crasbe/Protein/Pics/IMG_20130914_145044.jpg

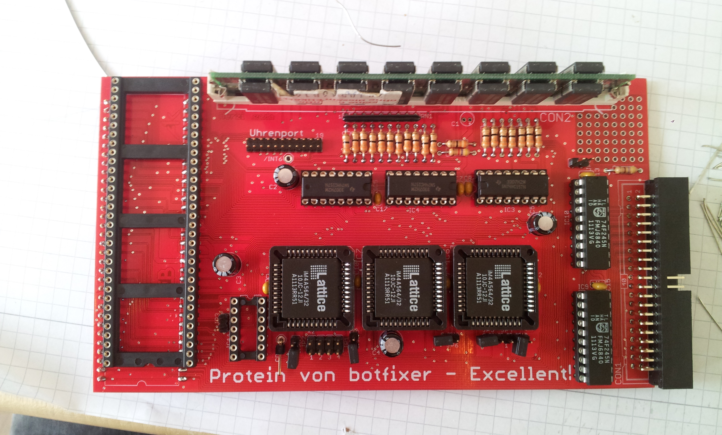
Pics/IMG_20130914_145044.jpg
