crasbe/Protein/Software/original/untouched_sources/DRAM/Projekt/a600_8mb_addon/a600_8mb_addon/4mb/README.txt

4mb version, PCMCIA friendly.

Memory is at $200000-$5fffff.

SOLDER ORDER: for pure 4mb board, solder only two RIGHT memory chips.
On the fully populated board, redundant chips will be inactive so everything OK.
