crasbe/Protein/Hardware/ISP-Rev.-1.0/pcb.png

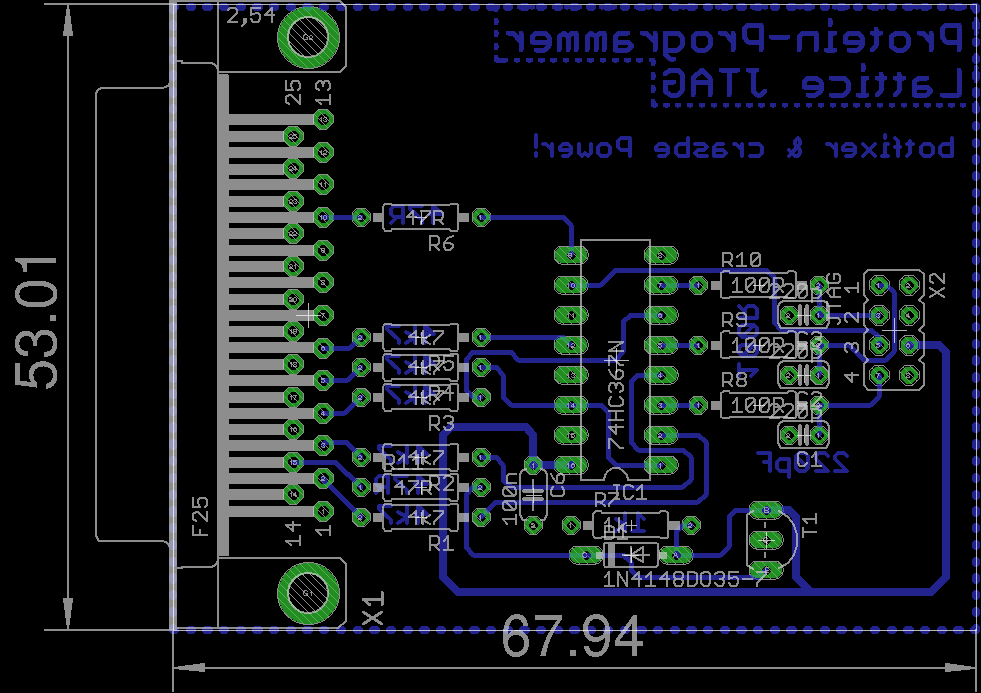
Hardware/ISP-Rev.-1.0/pcb.png
