crasbe/Protein/Hardware/ISP-Rev.-1.2/pcb.png

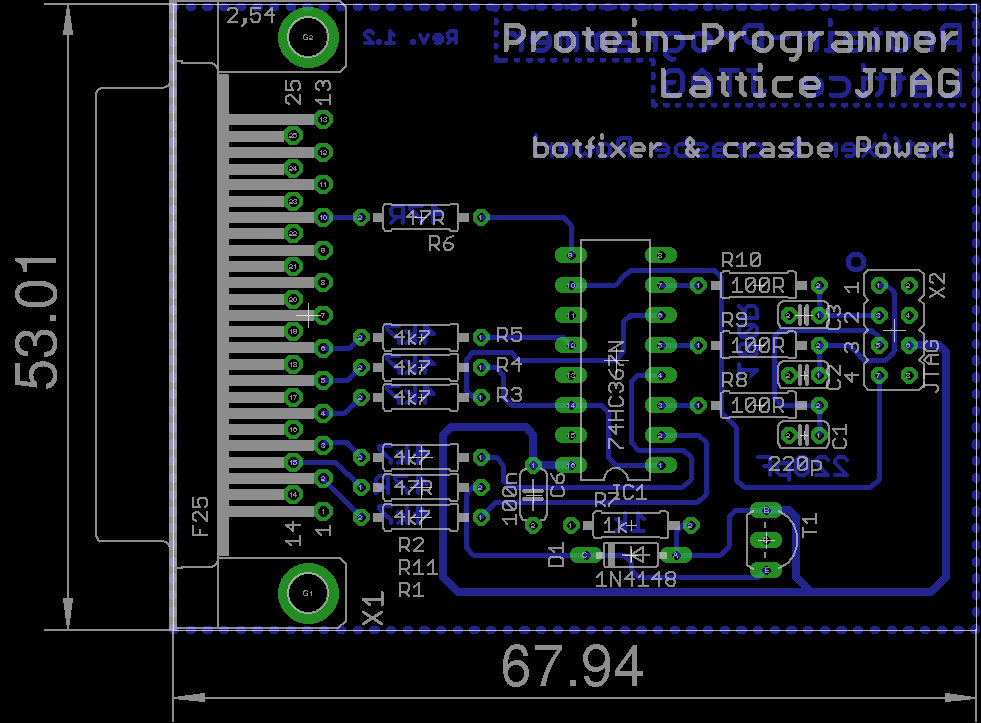
Hardware/ISP-Rev.-1.2/pcb.png
