crasbe/Protein/Hardware/Rev.-1.0/pcb.png

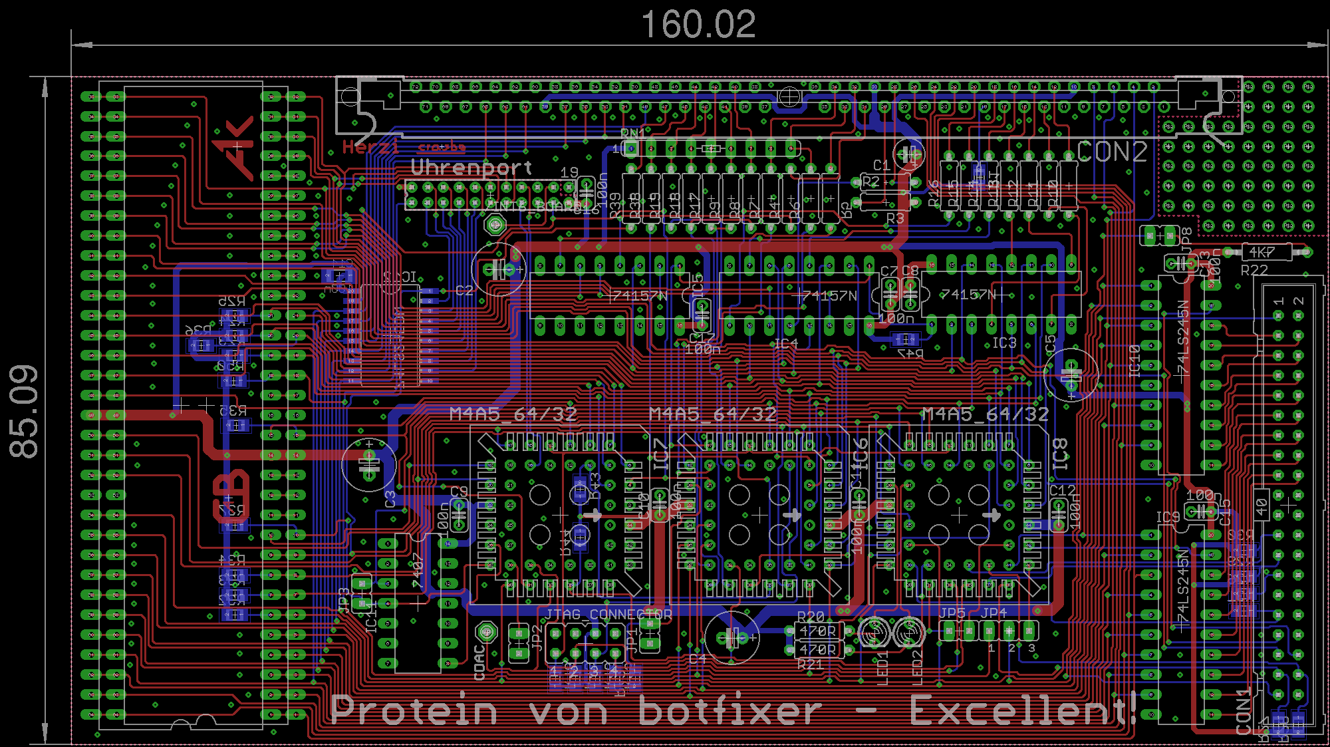
Hardware/Rev.-1.0/pcb.png
