crasbe/Protein/Hardware/Rev.-1.1/pcb.png

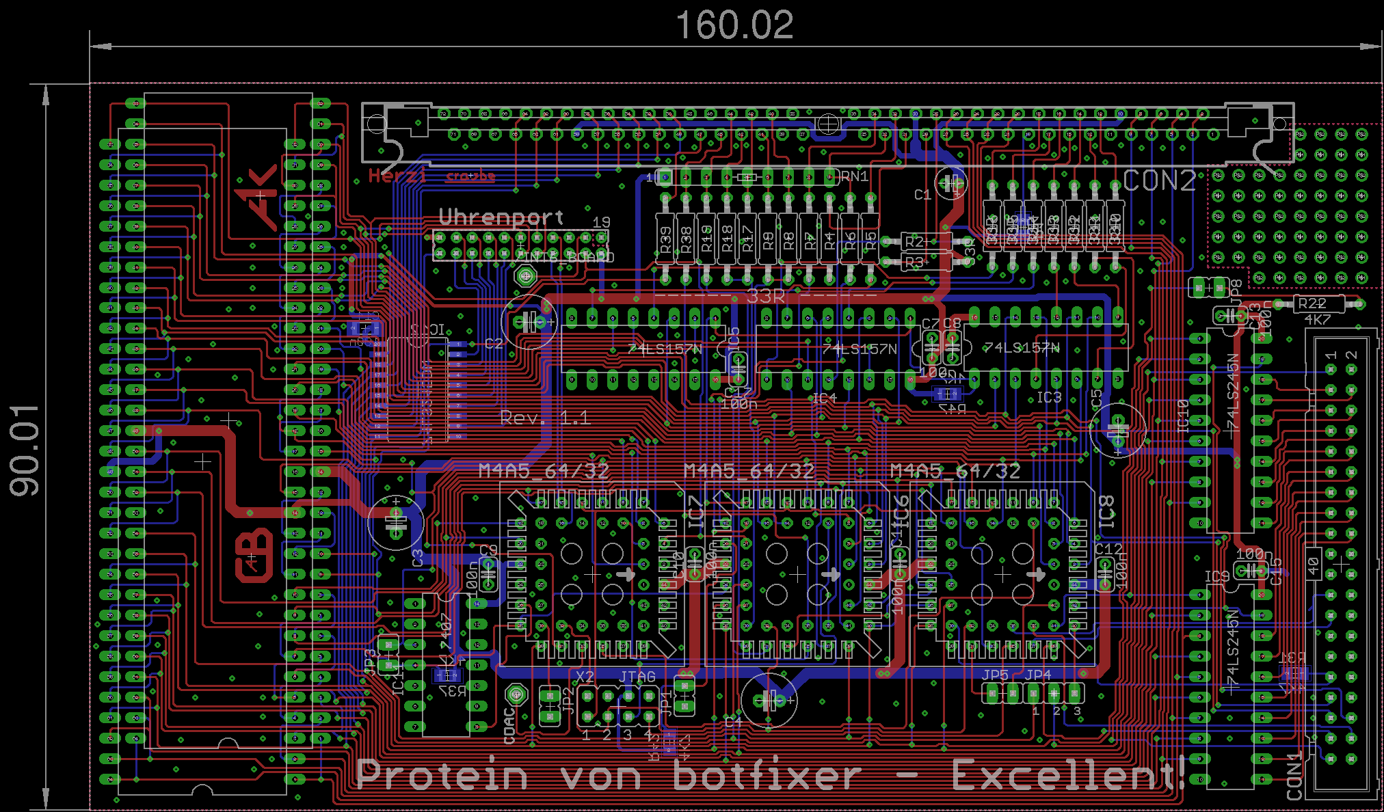
Hardware/Rev.-1.1/pcb.png
