crasbe/Protein/Hardware/Rev.-1.2/pcb.png

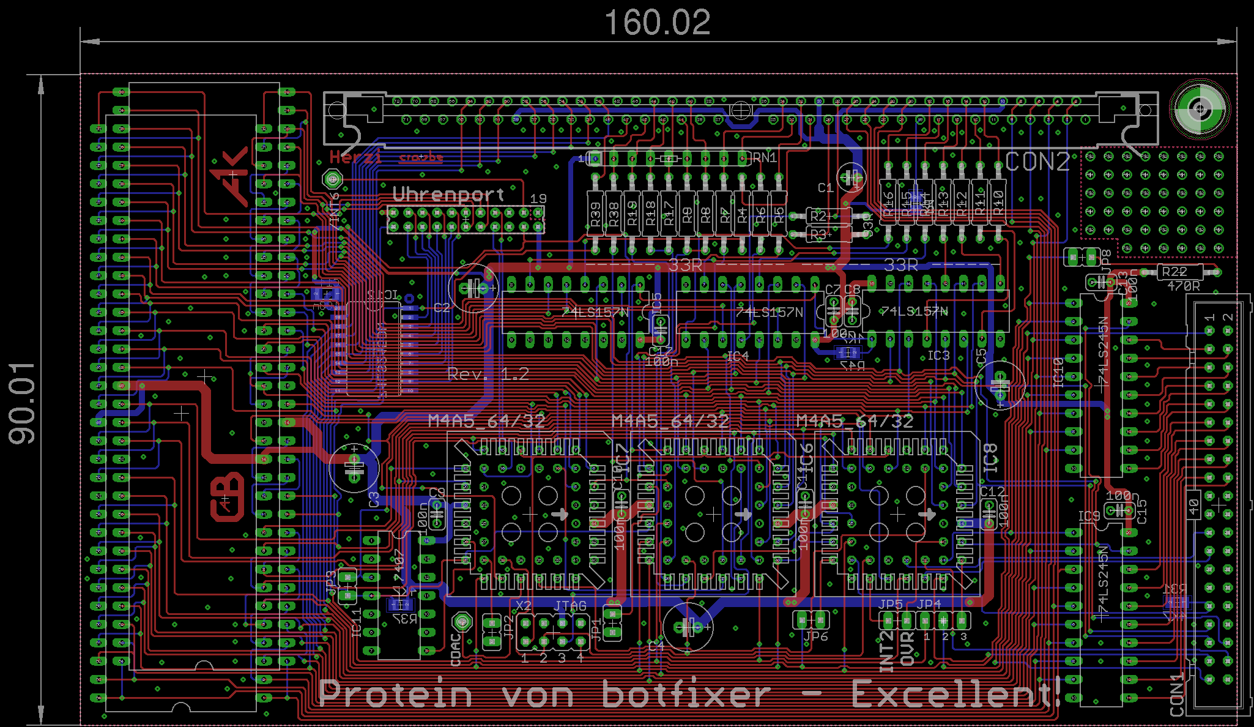
Hardware/Rev.-1.2/pcb.png
