crasbe/Protein/Pics/IMG_20130913_210121.jpg

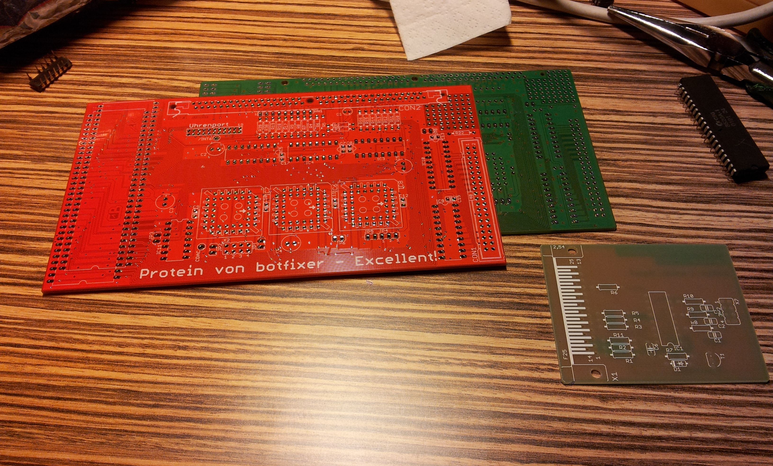
Pics/IMG_20130913_210121.jpg
