crasbe/Protein/Pics/IMG_20130913_210151.jpg

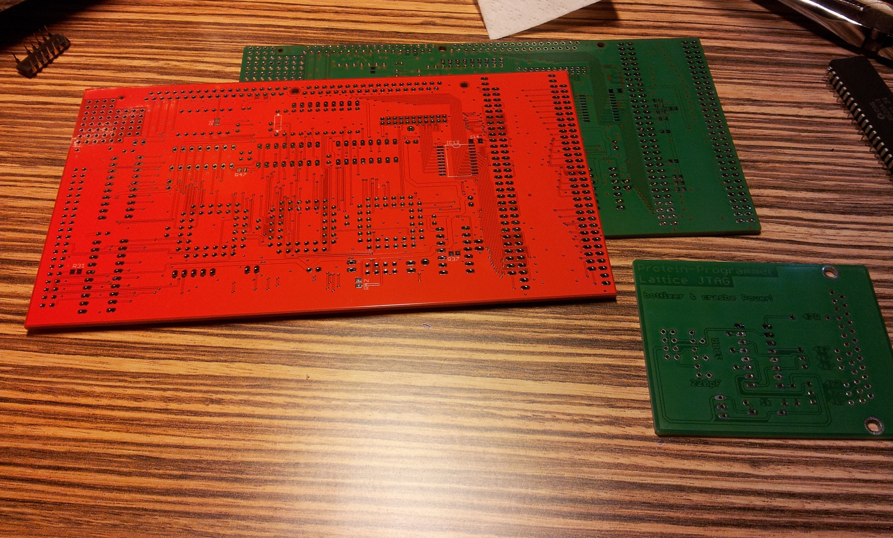
Pics/IMG_20130913_210151.jpg
