crasbe/Protein/Pics/IMG_20130914_150607.jpg

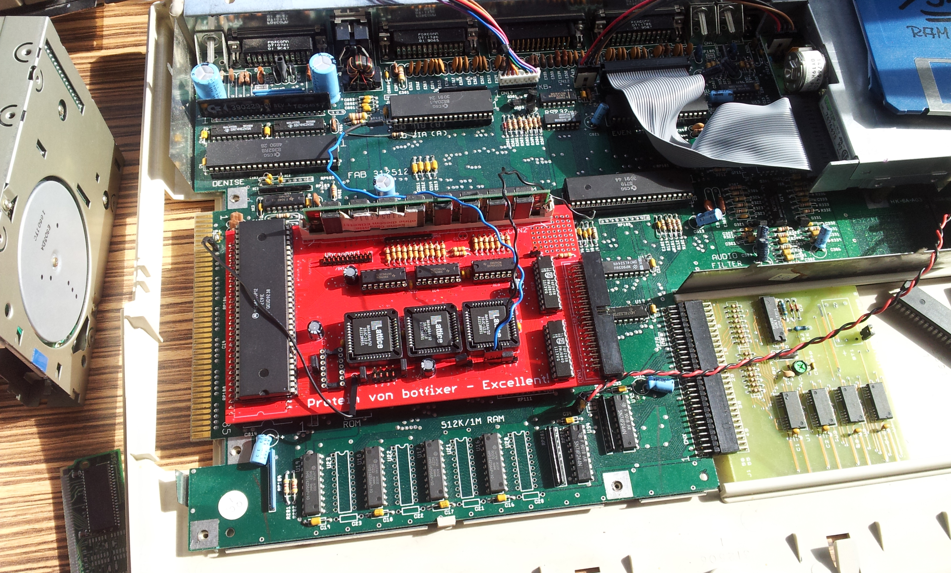
Pics/IMG_20130914_150607.jpg
