crasbe/Protein/Pics/IMG_20130914_170321.jpg

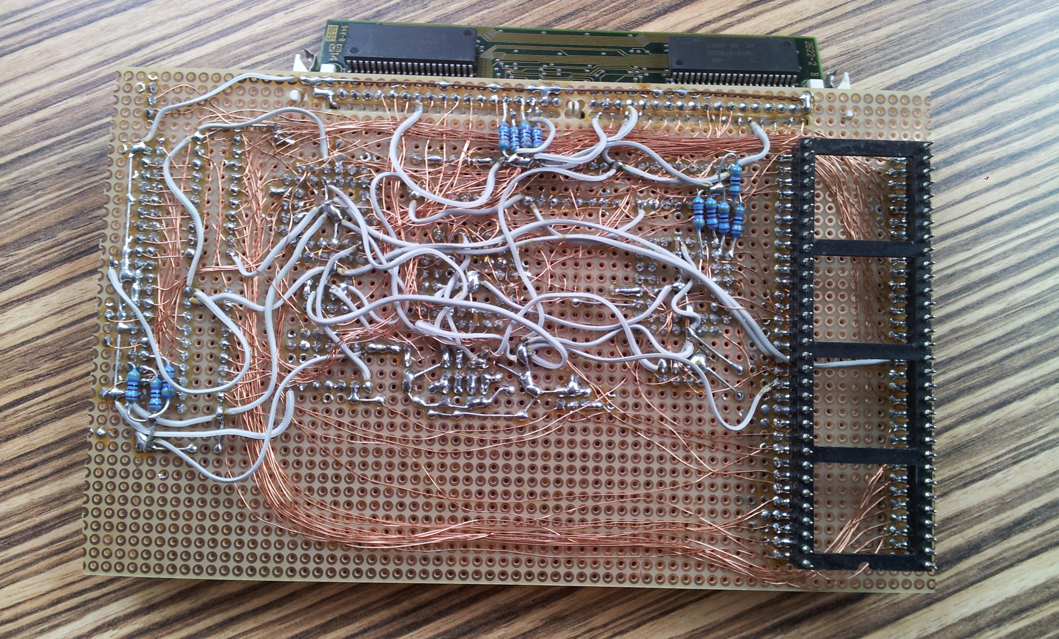
Pics/IMG_20130914_170321.jpg
