crasbe/Protein/Pics/IMG_20130914_170358.jpg

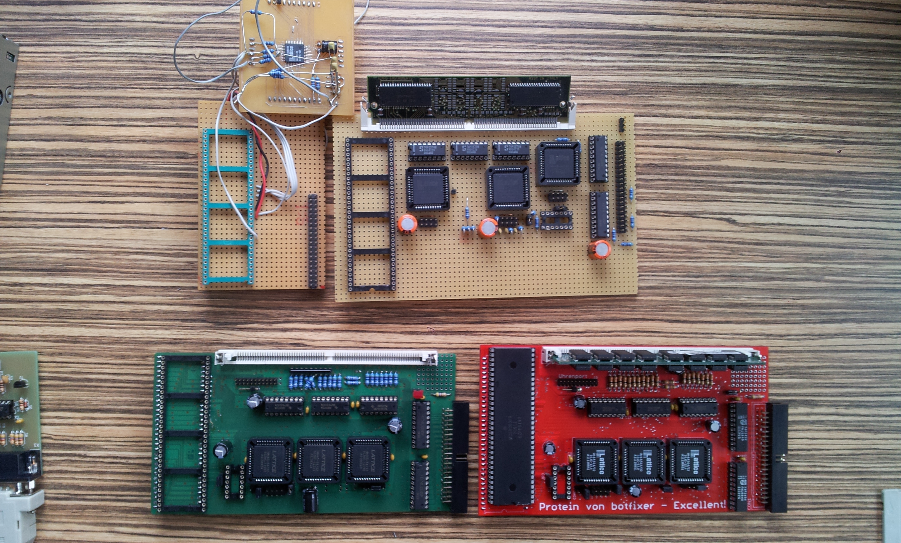
Pics/IMG_20130914_170358.jpg
