crasbe/Protein/Software/original/untouched_sources/Clockport/Clockport.png

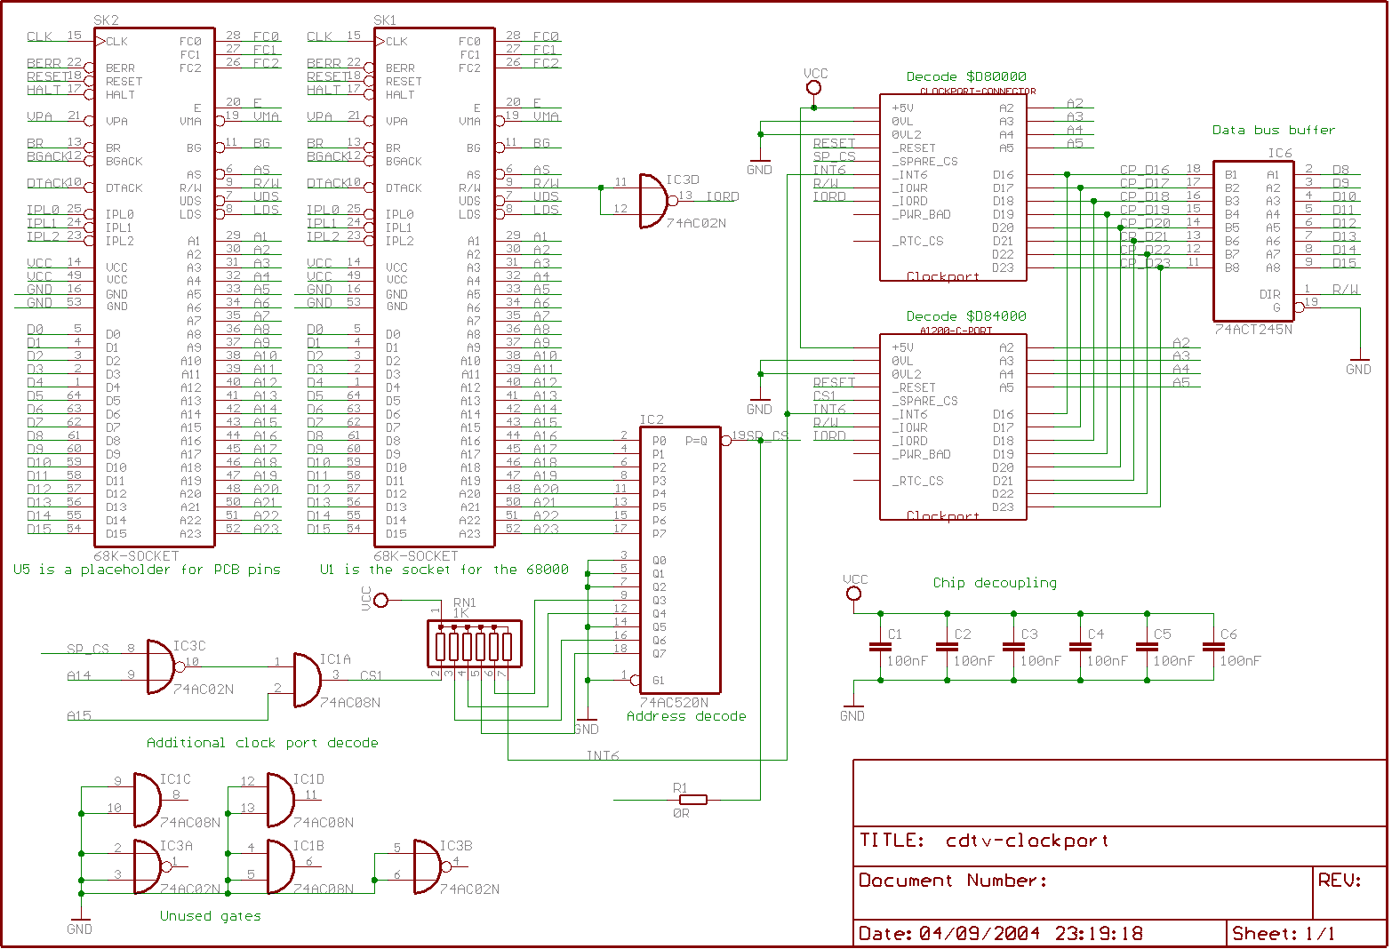
Software/original/untouched_sources/Clockport/Clockport.png
