crasbe/Protein/Software/original/untouched_sources/DRAM/Projekt/a600_8mb/a600_8mb/photos/4.jpg

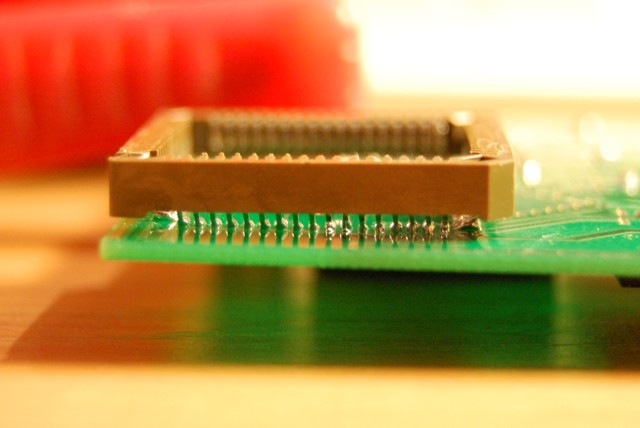
Software/original/untouched_sources/DRAM/Projekt/a600_8mb/a600_8mb/photos/4.jpg
