crasbe/Protein/Software/original/untouched_sources/IDE/IDE-harddisk projects for Amiga-Dateien/abidebot.jpg

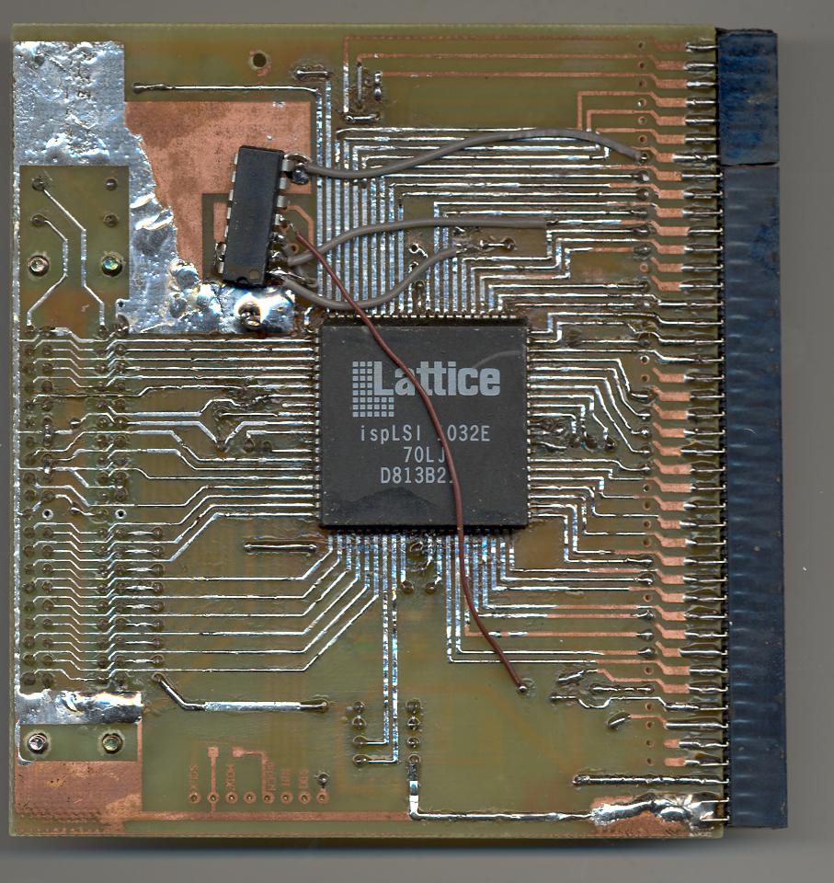
Software/original/untouched_sources/IDE/IDE-harddisk projects for Amiga-Dateien/abidebot.jpg
