crasbe/Protein/Software/original/untouched_sources/IDE/IDE-harddisk projects for Amiga-Dateien/abidetop.jpg

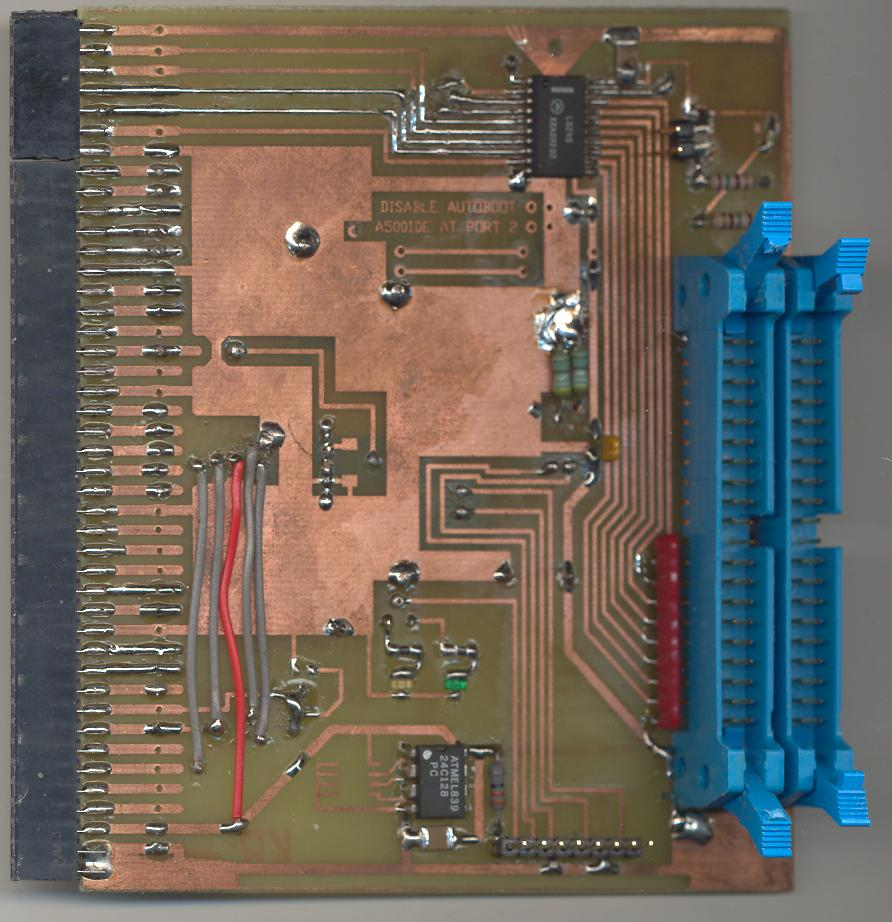
Software/original/untouched_sources/IDE/IDE-harddisk projects for Amiga-Dateien/abidetop.jpg
