crasbe/Protein/Hardware/ISP-Rev.-1.0/lattice-isp-pcb.pdf

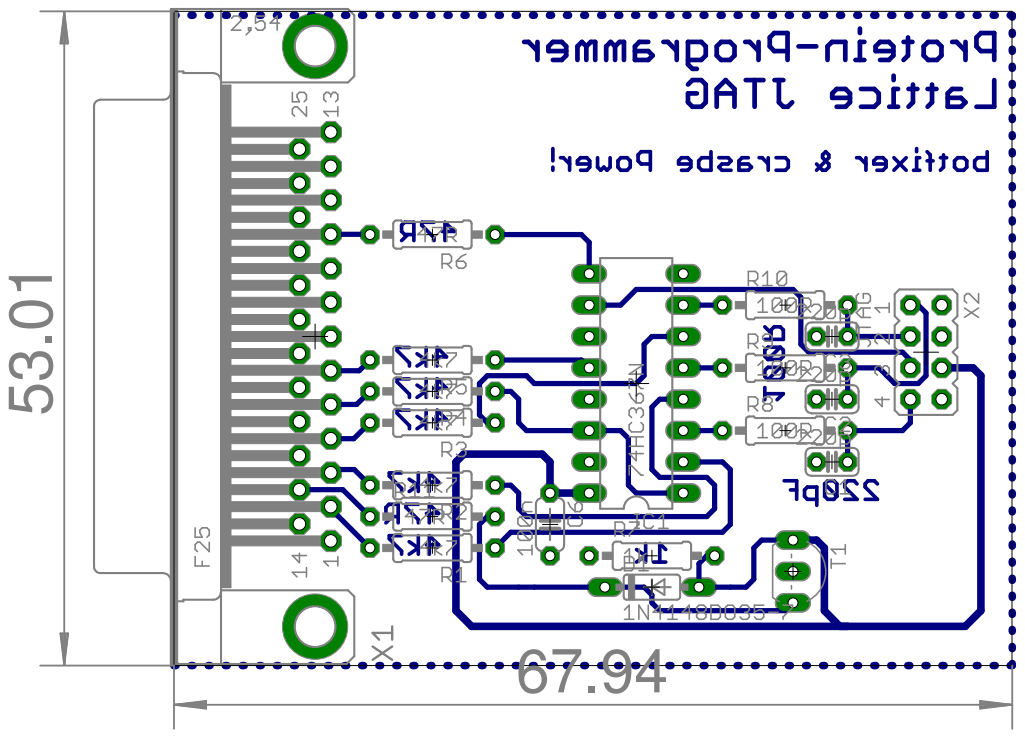
[picture p24: page 1]
