crasbe/Protein/Hardware/ISP-Rev.-1.0/lattice-isp-sch.pdf

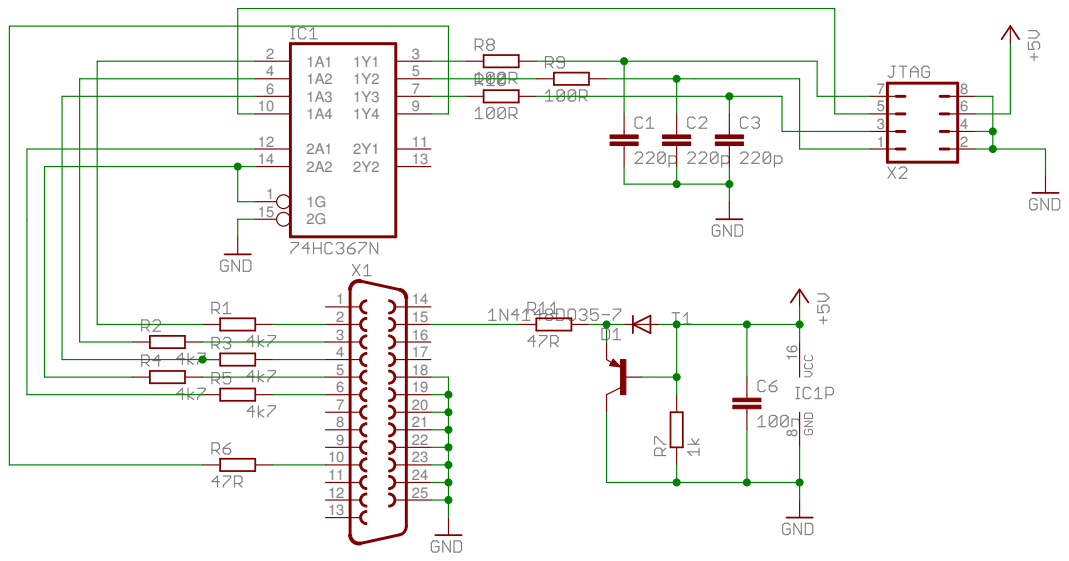
[picture p25: page 1]
