crasbe/Protein/Hardware/ISP-Rev.-1.2/lattice-isp-brd.pdf

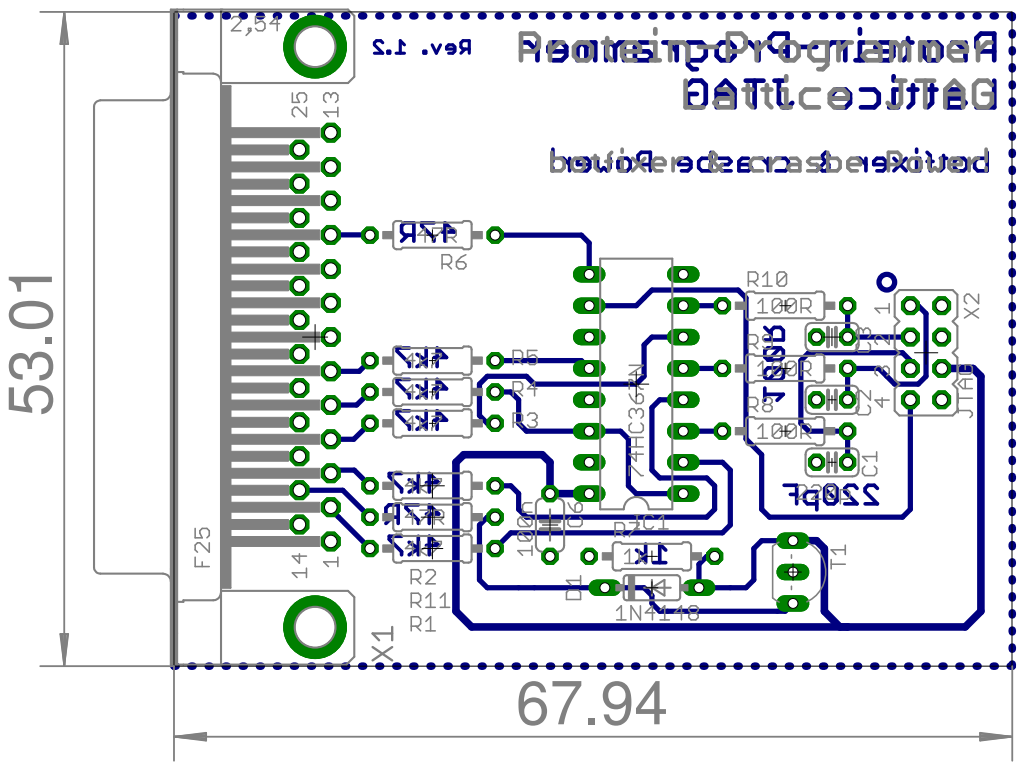
[picture p26: page 1]
