crasbe/Protein/Hardware/ISP-Rev.-1.2/lattice-isp-sch.pdf

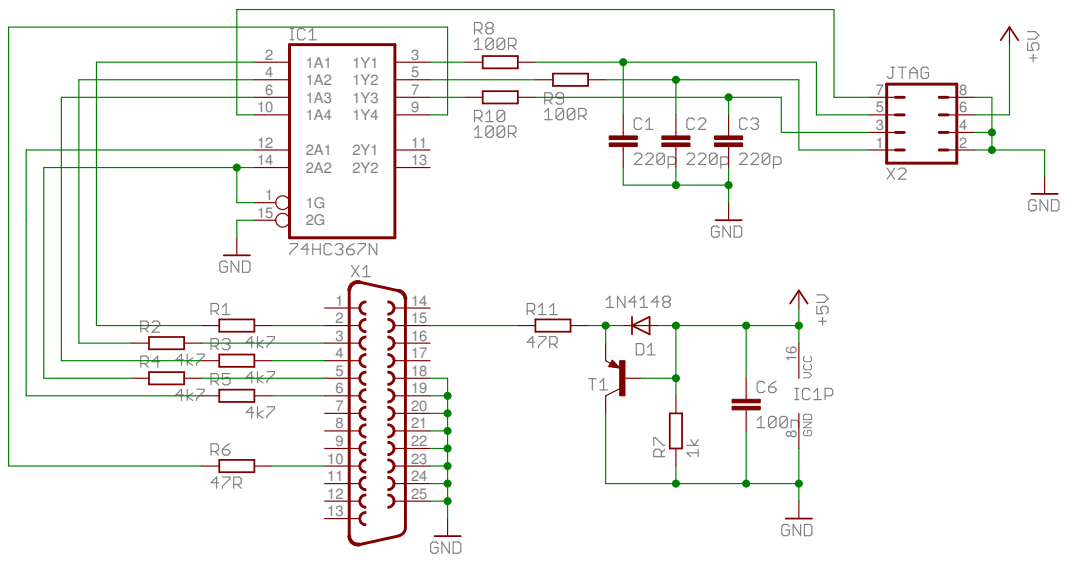
[picture p27: page 1]
