crasbe/Protein/Hardware/Rev.-1.0/Protein-brd.pdf

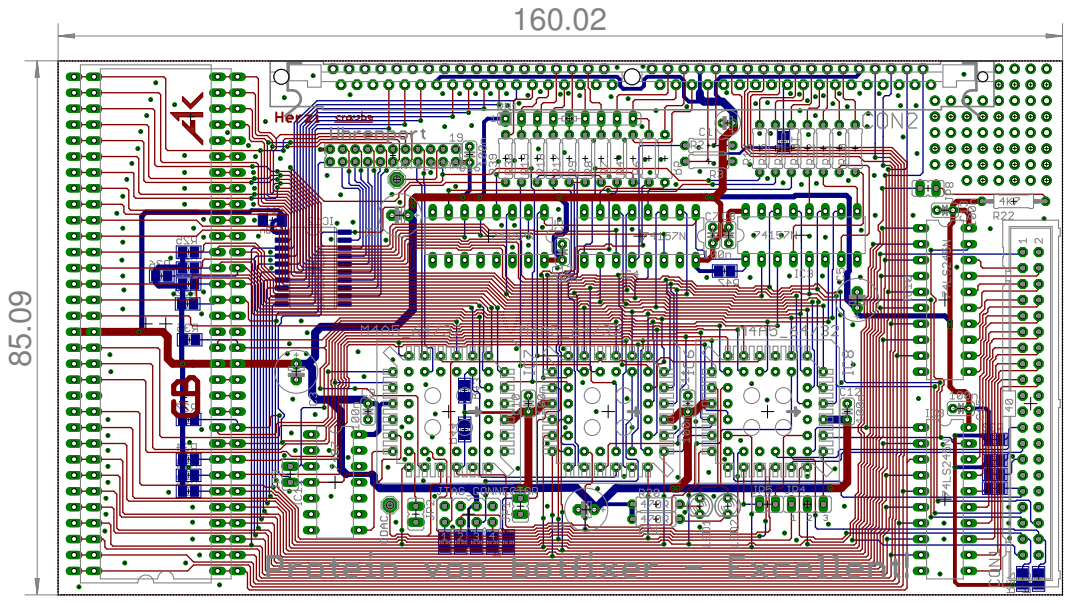
[picture p28: page 1]
