crasbe/Protein/Hardware/Rev.-1.0/Protein-sch.pdf

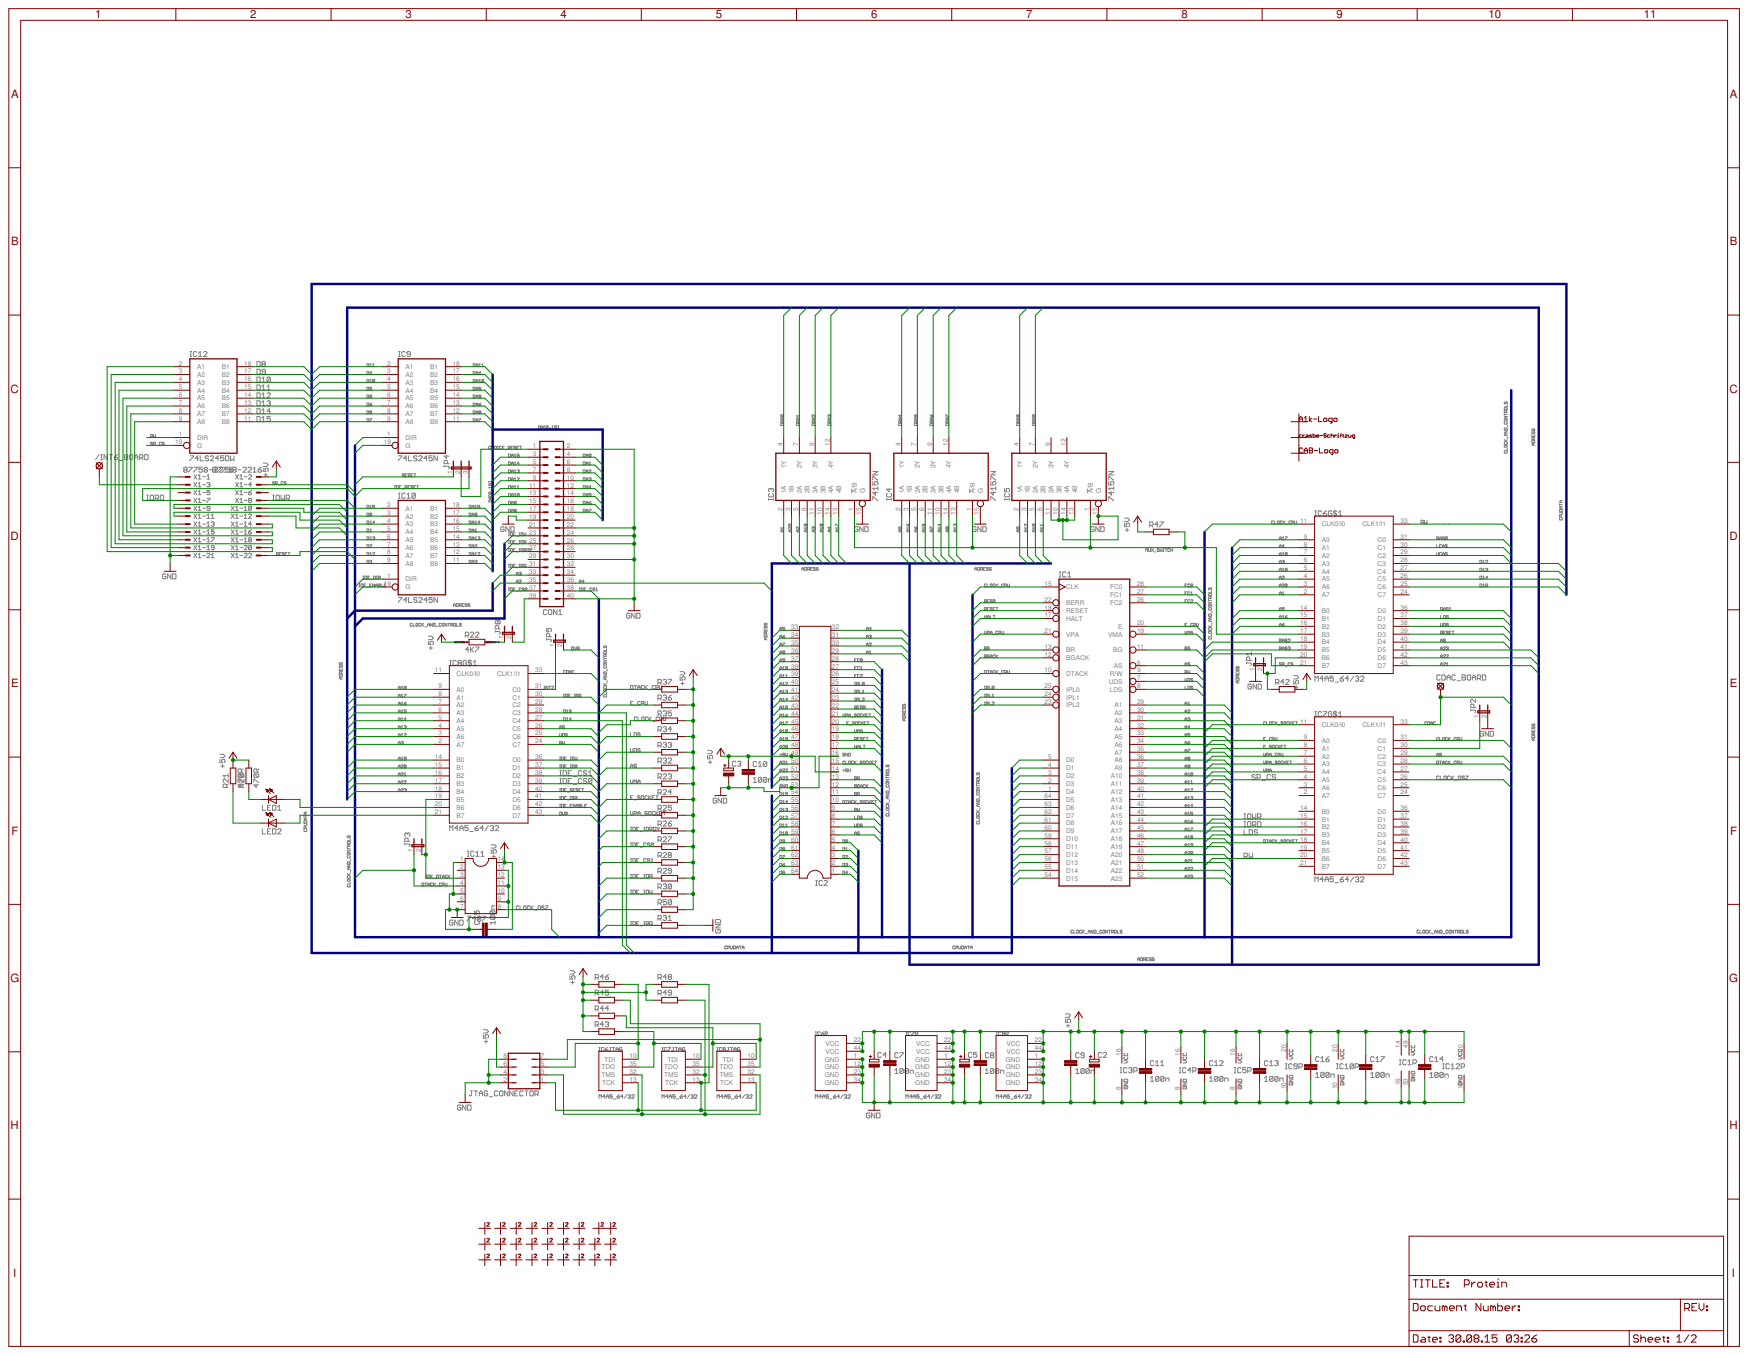
[picture p29: page 1]

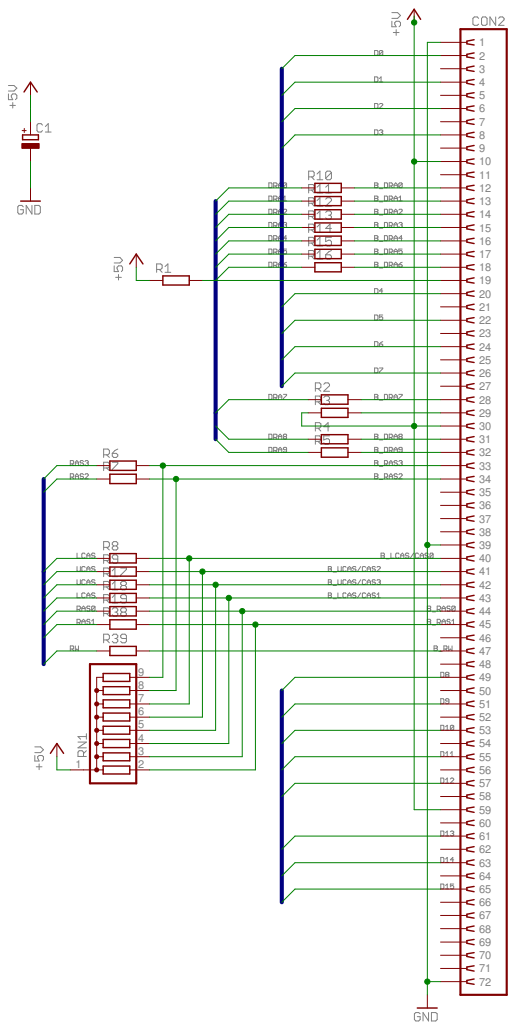
[picture p30: page 2]
