crasbe/Protein/Hardware/Rev.-1.1/Protein-brd.pdf

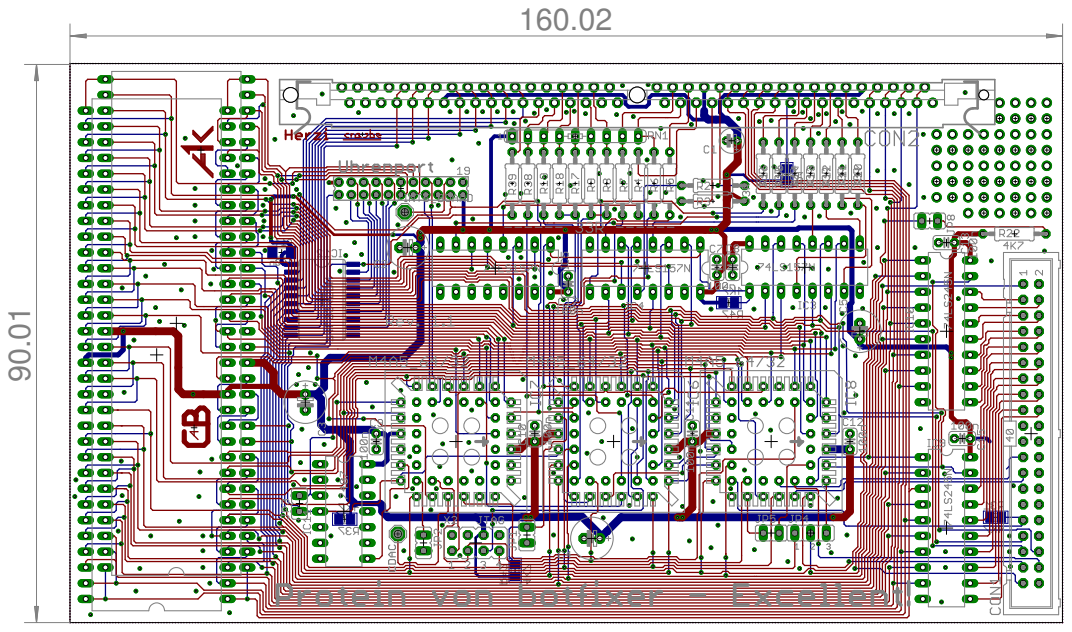
[picture p31: page 1]
