crasbe/Protein/Hardware/Rev.-1.1/Protein-sch.pdf

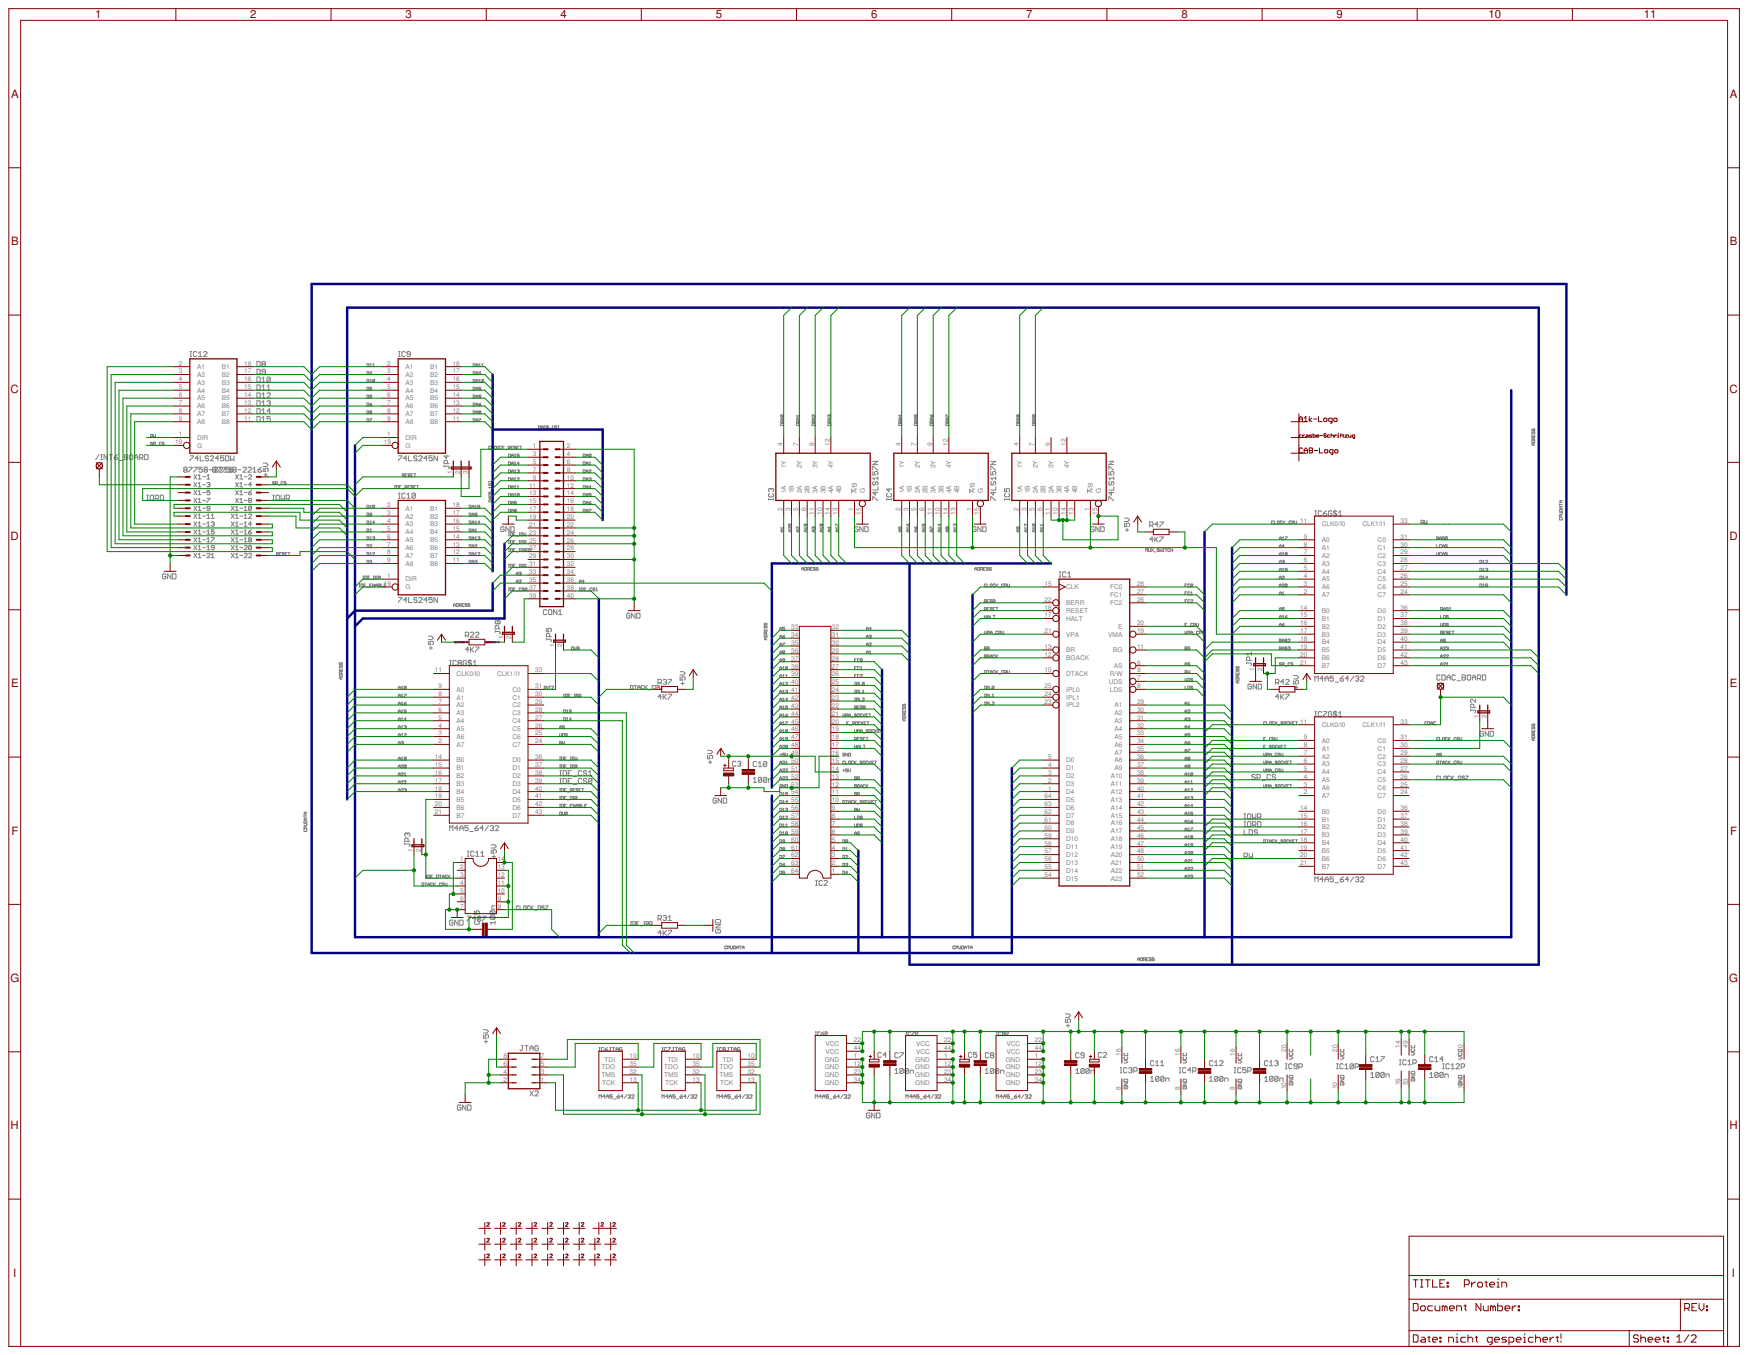
[picture p32: page 1]

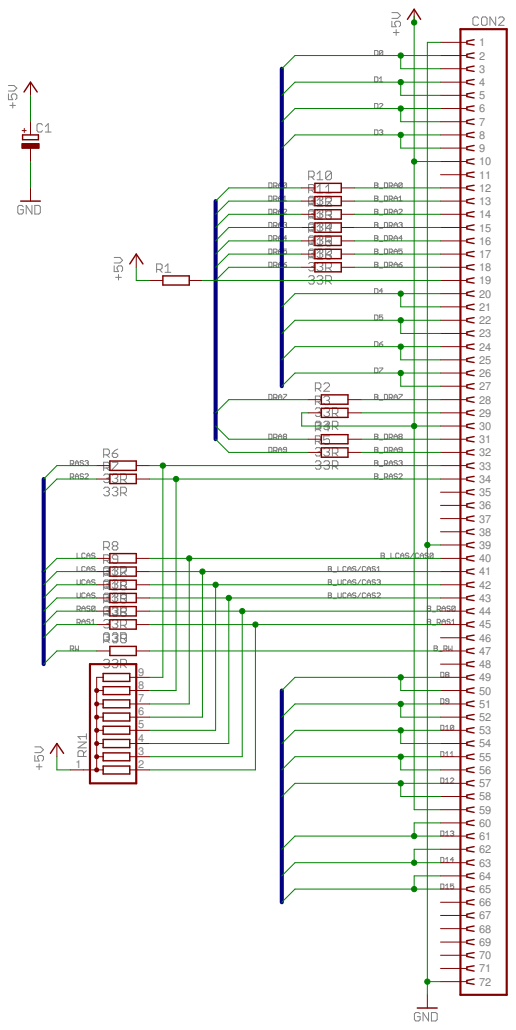
[picture p33: page 2]
