crasbe/Protein/Hardware/Rev.-1.2/Protein-sch.pdf

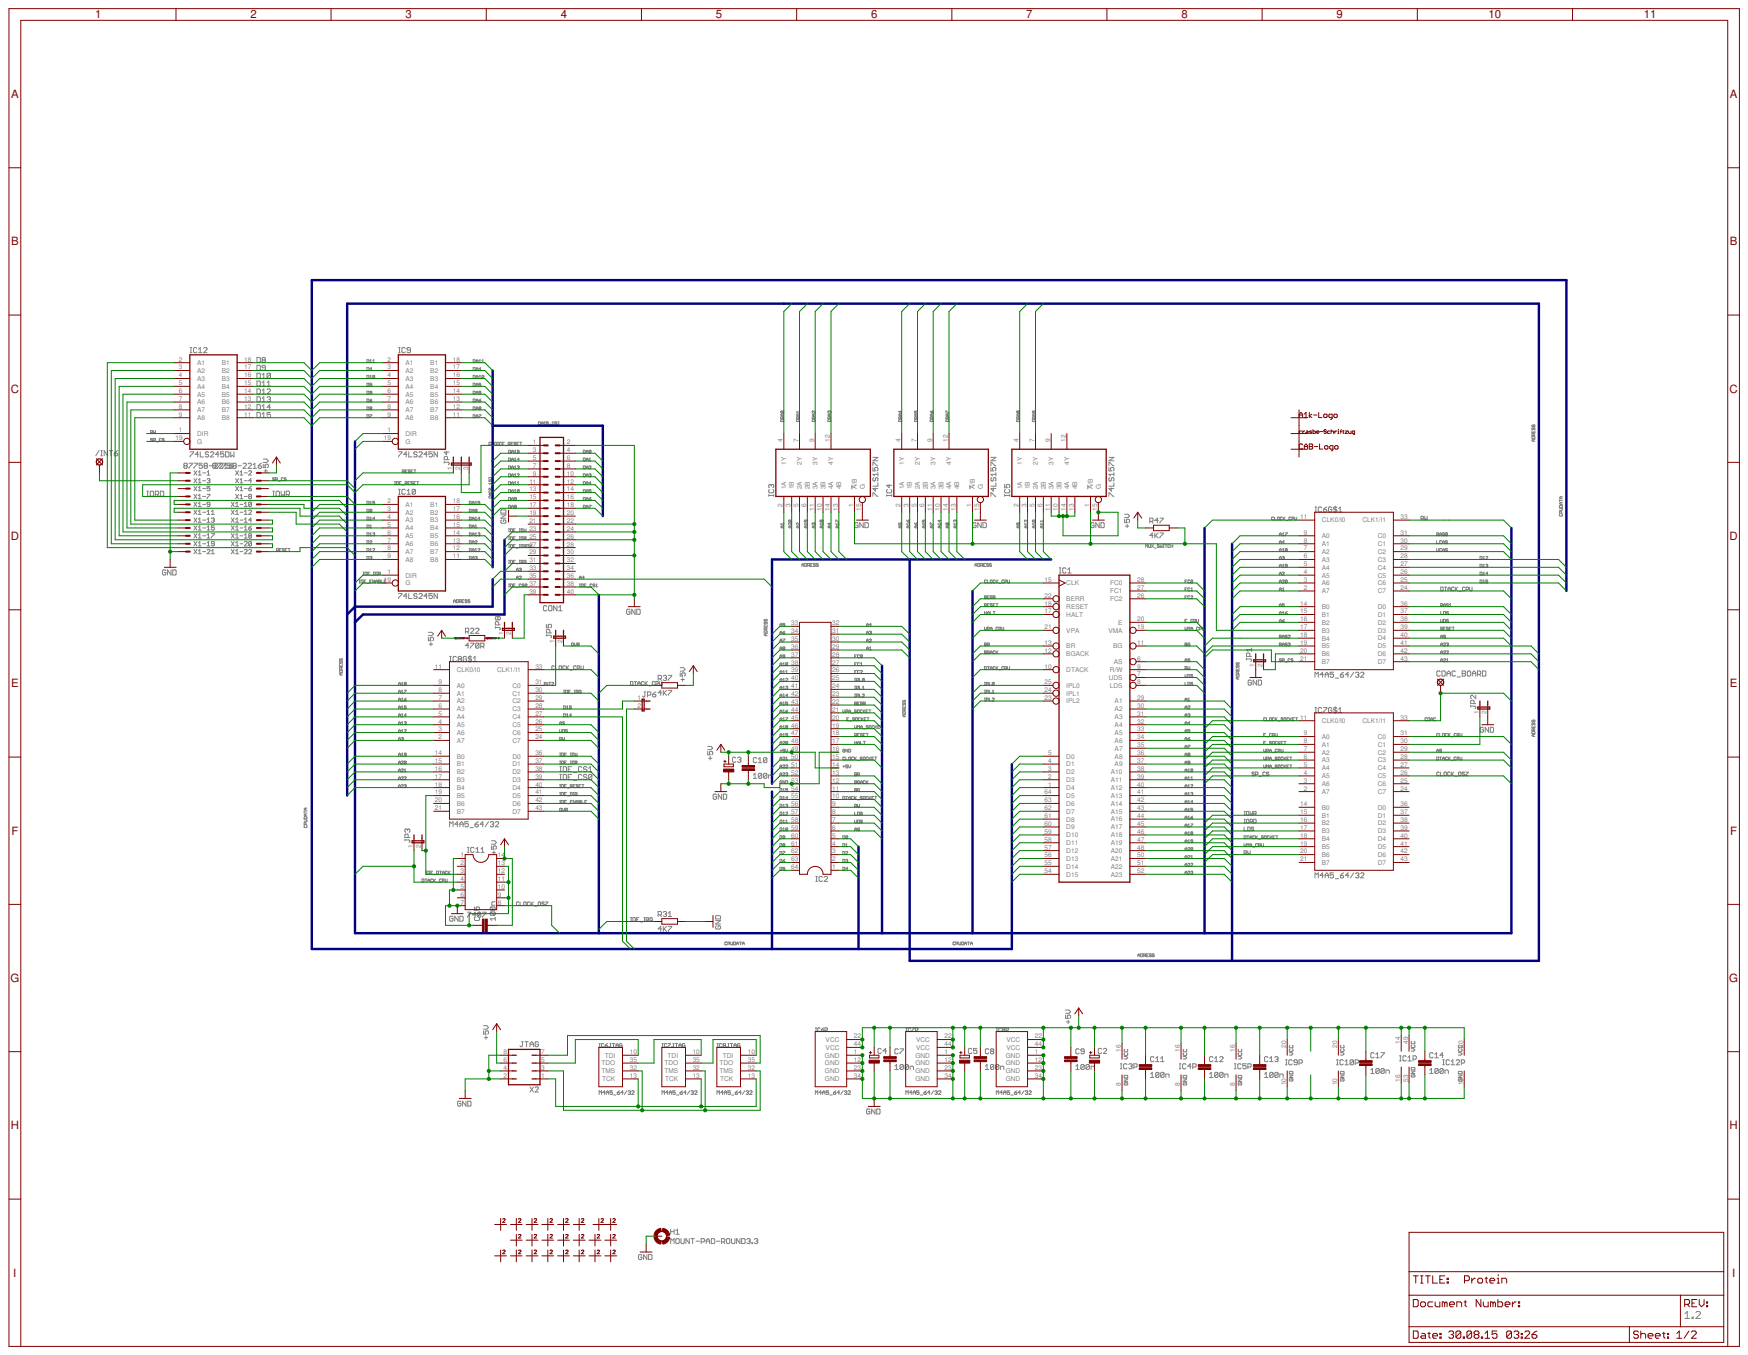
[picture p34: page 1]

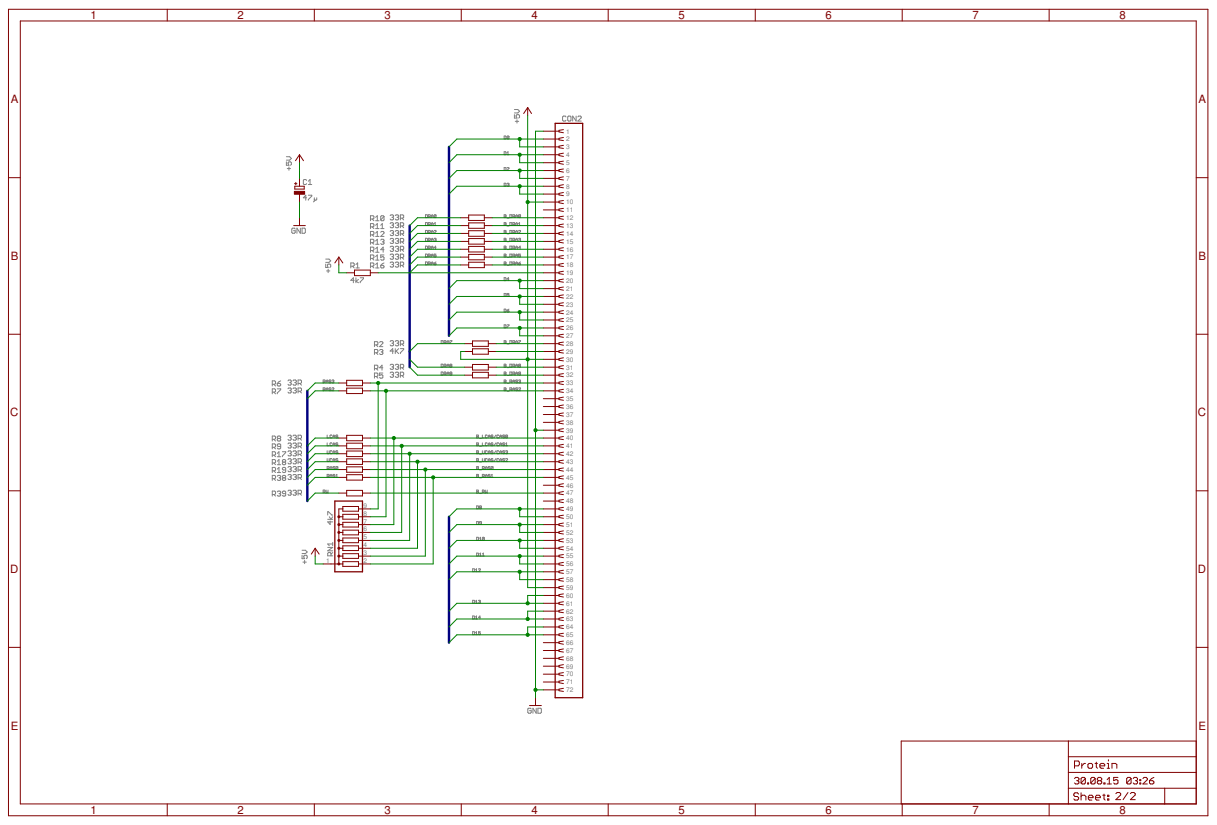
[picture p35: page 2]
