crasbe/Protein/Hardware/Rev.-1.2/Protein.pdf

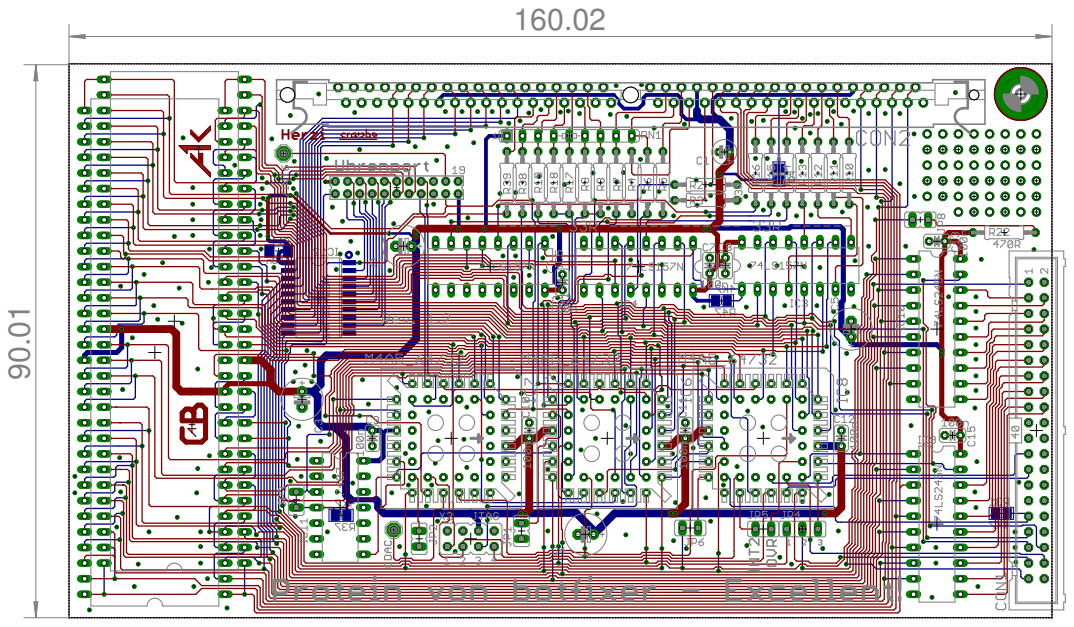
[picture p36: page 1]
