crasbe/Protein/Software/original/untouched_sources/DRAM/Projekt/a600_8mb/a600_8mb/sch_pcb/a600_8mb.pdf

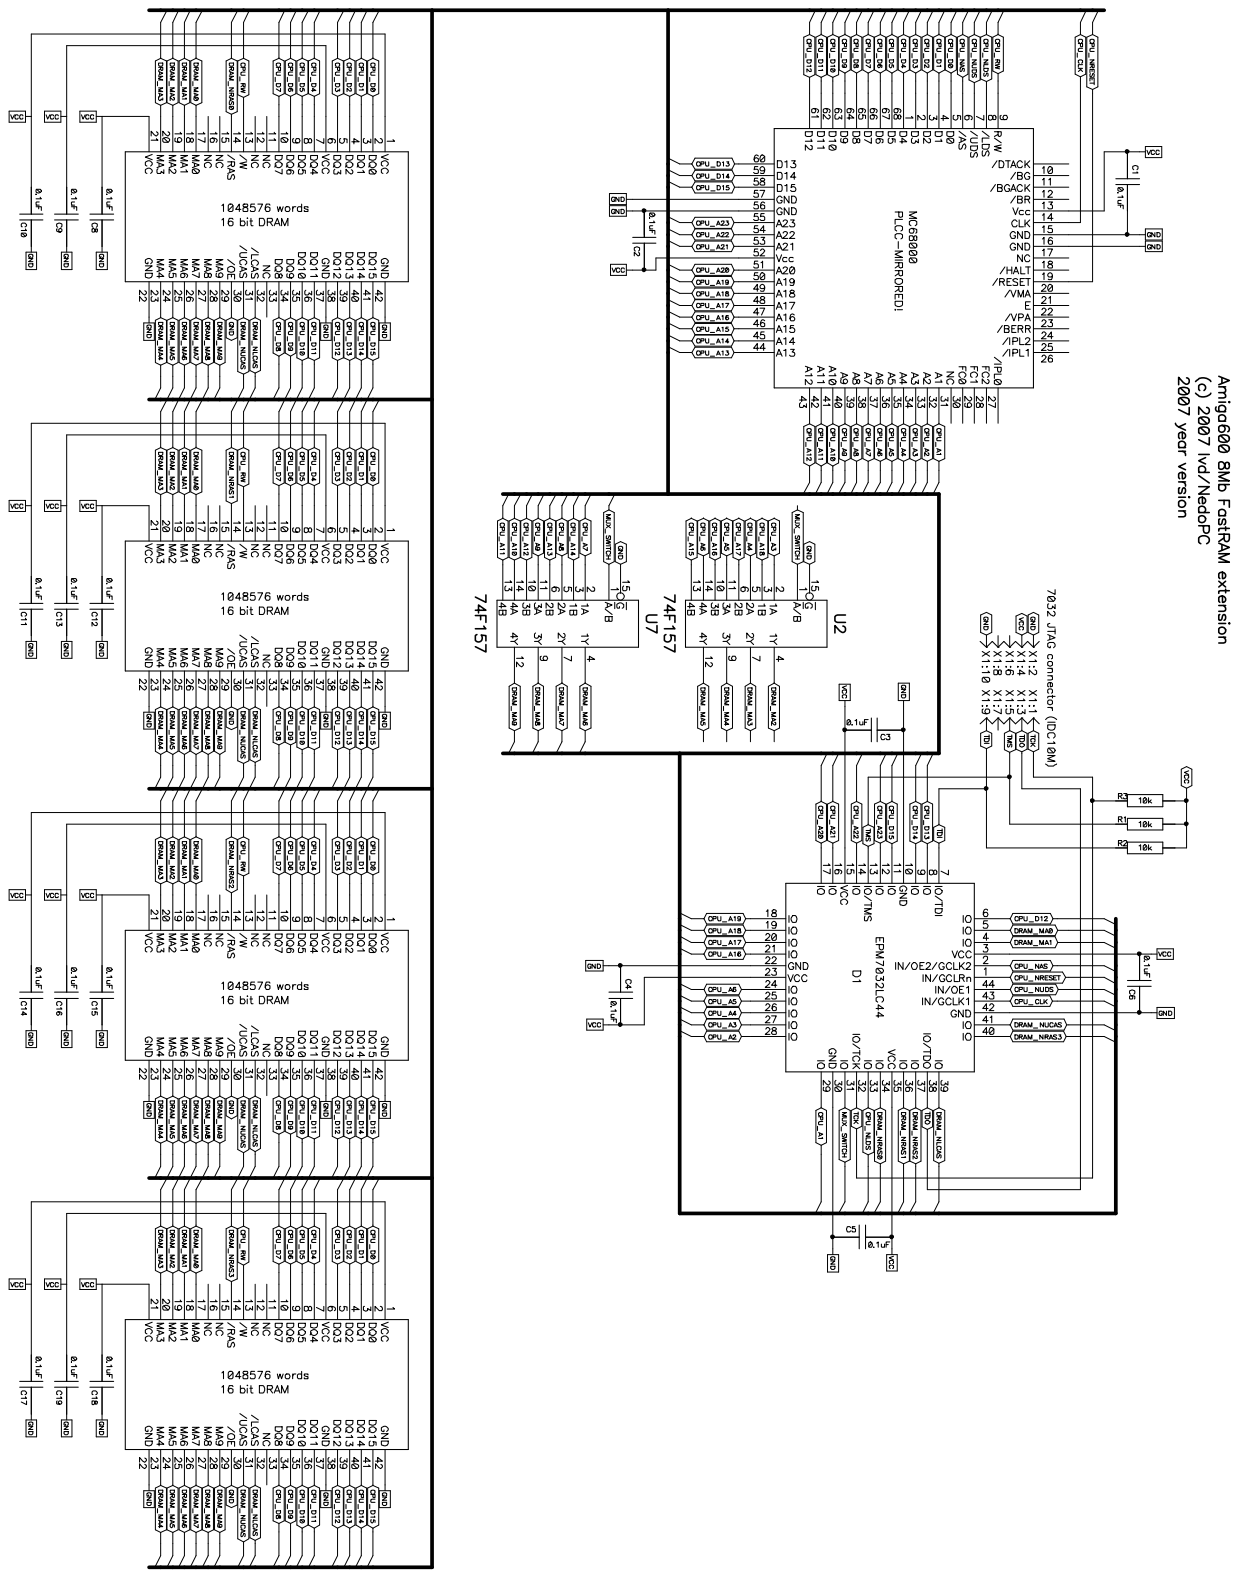
[picture p37: page 1]
