crasbe/Protein/(list of files, drawings)

Other design files:
Software/original/untouched_sources/DRAM/Projekt/a600_8mb/a600_8mb/sch_pcb/a600_8mb.pcb
