crasbe/Protein/Hardware/ISP-Rev.-1.2/lattice-isp.brd

## EAGLE design Hardware/ISP-Rev.-1.2/lattice-isp.brd (2015-08-30)

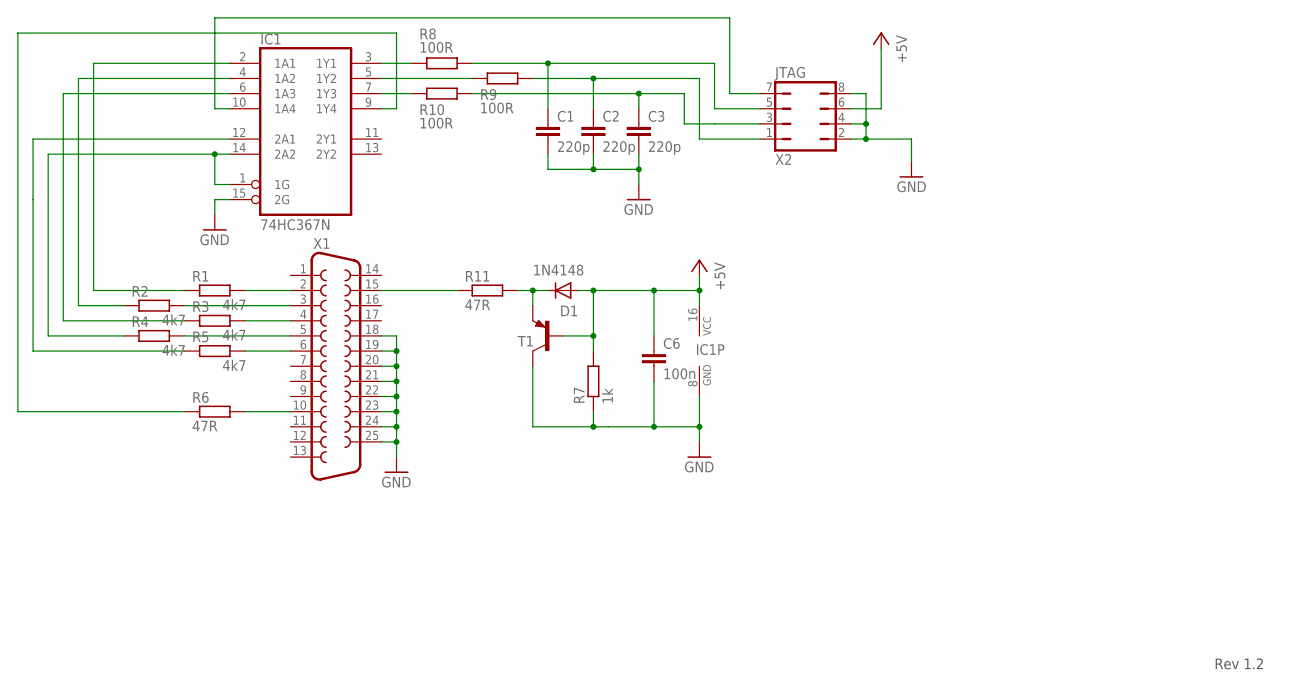
[picture p38: schematic lattice-isp.sch]

Parts:
C1, C2, C3: 220p; C025-024X044
C6: 100n; C050-024X044
D1: 1N4148; DO35-7
IC1: 74HC367N; DIL16
R1, R2, R3, R4, R5: 4k7; 0207/10
R6, R11: 47R; 0207/10
R7: 1k; 0207/10
R8, R9, R10: 100R; 0207/10
T1: BC636-PNP-TO92-BCE; TO92-BCE
X1: F25HP
X2: JTAG; JP4Q

Connections:
+5V: C6.1, D1.A, IC1.16 (VCC), R7.2, T1.B, X2.6
GND: C1.2, C2.2, C3.2, C6.2, IC1.8 (GND), IC1.15 (2G), R7.1, T1.C, X1.18, X1.19, X1.20, X1.21, X1.22, X1.23, X1.24, X1.25, X2.2, X2.4, X2.8
unnamed: IC1.3 (1Y1), R8.1
unnamed: R1.2, X1.2
unnamed: R2.2, X1.3
unnamed: R3.2, X1.4
unnamed: R4.2, X1.5
unnamed: R5.2, X1.6
unnamed: R6.2, X1.10
unnamed: IC1.2 (1A1), R1.1
unnamed: IC1.4 (1A2), R2.1
unnamed: IC1.6 (1A3), R3.1
unnamed: IC1.1 (1G), IC1.14 (2A2), R4.1
unnamed: IC1.12 (2A1), R5.1
unnamed: IC1.9 (1Y4), R6.1
unnamed: IC1.5 (1Y2), R9.1
unnamed: IC1.7 (1Y3), R10.1
unnamed: C3.1, R10.2, X2.3
unnamed: D1.C, R11.2, T1.E
unnamed: R11.1, X1.15
TCK: C2.1, R9.2, X2.1
TDI: C1.1, R8.2, X2.5
TDO: IC1.10 (1A4), X2.7

Notes on the sheet:
Rev 1.2

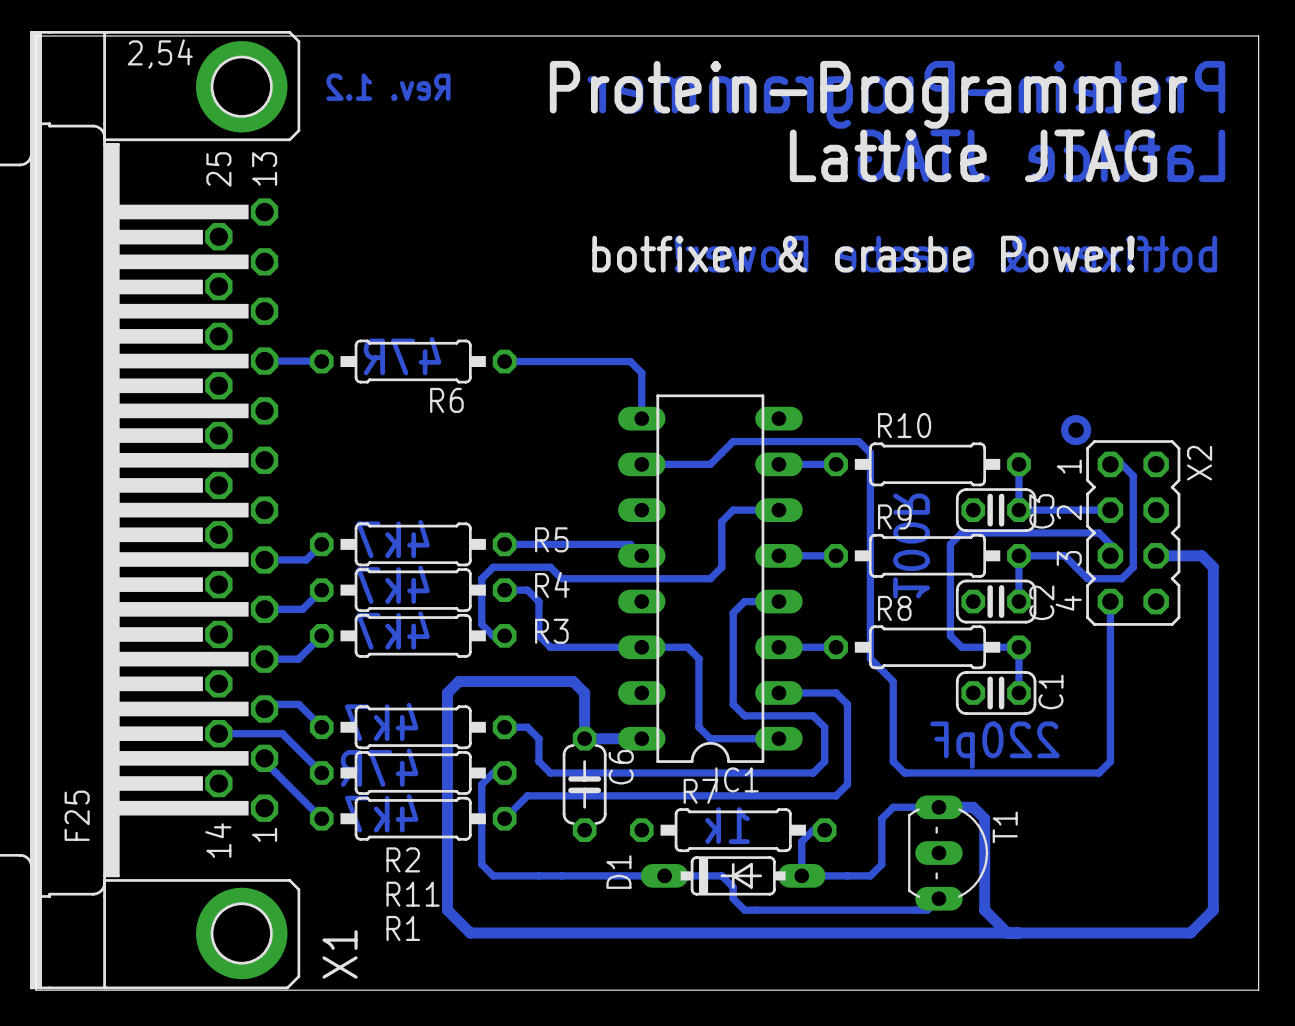
[picture p39: board lattice-isp.brd from above]

Board: 2 copper layers, 67.9 x 53.0 mm, 20 parts (0 on the bottom side), 23 nets.
